APathak666/Hyperloop-2017-Sorted-/PCB/PCBs_routed/FINAL_PCBS/control_pcb_final/CONTROL PCB.pdf

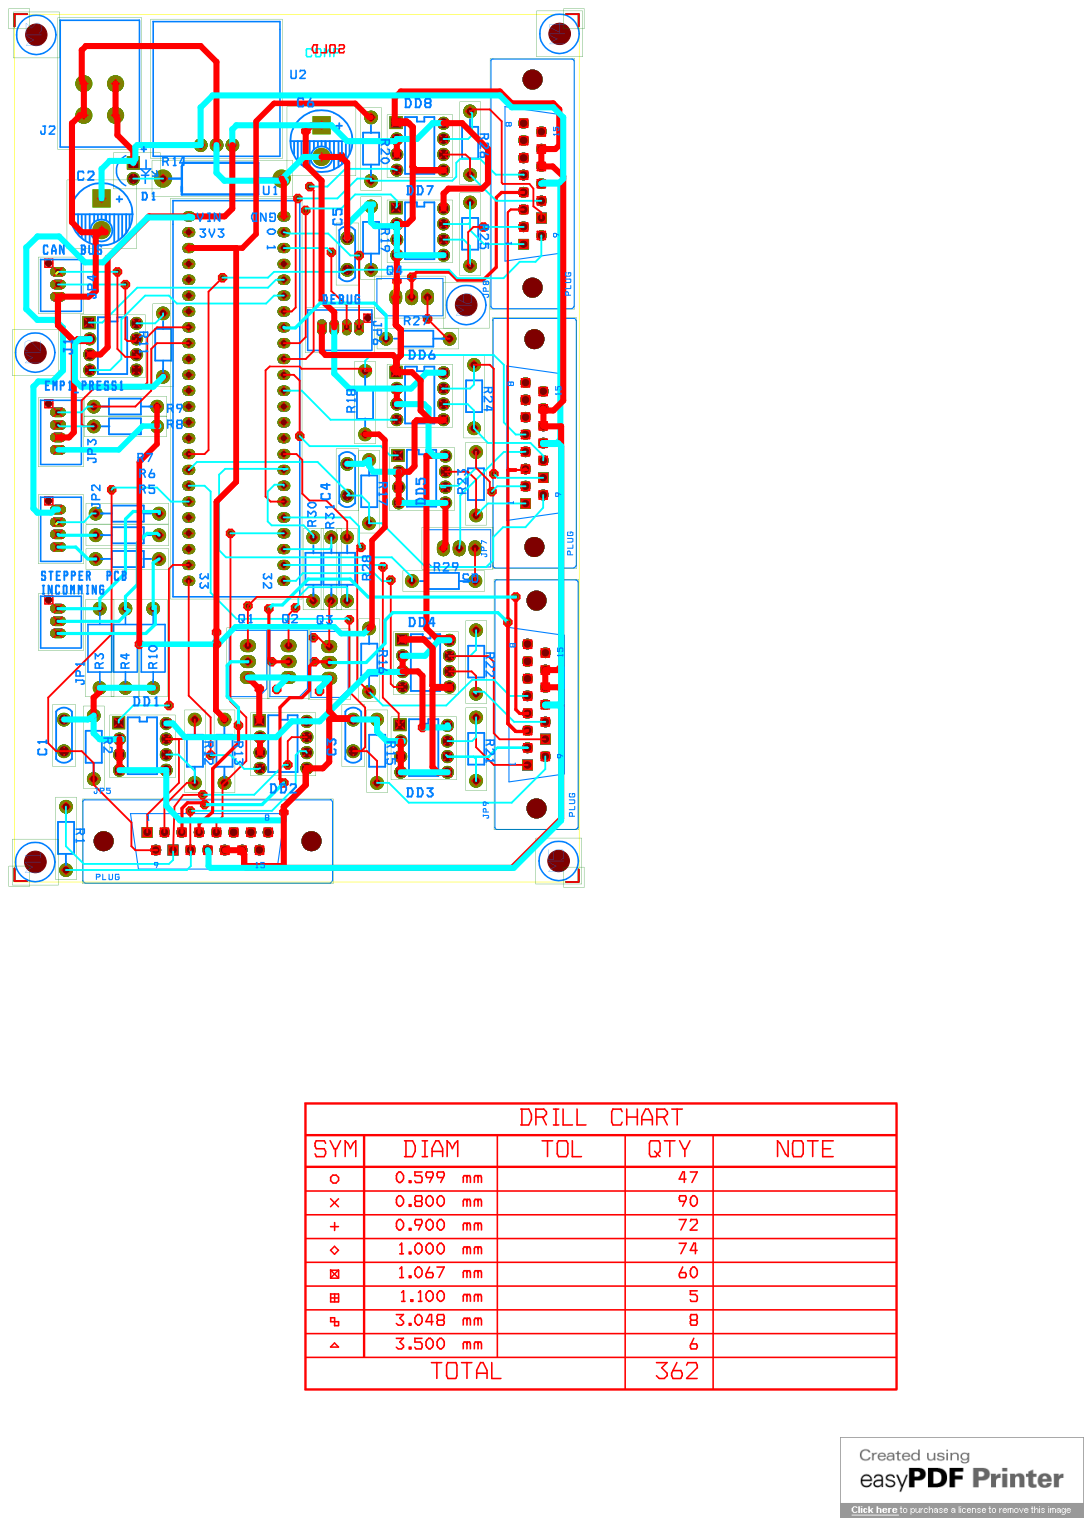
[picture p2: page 1]
