APathak666/Hyperloop-2017-Sorted-/PCB/PCBs_routed/FINAL_PCBS/navigation_pcb_final/NAV PCB.pdf

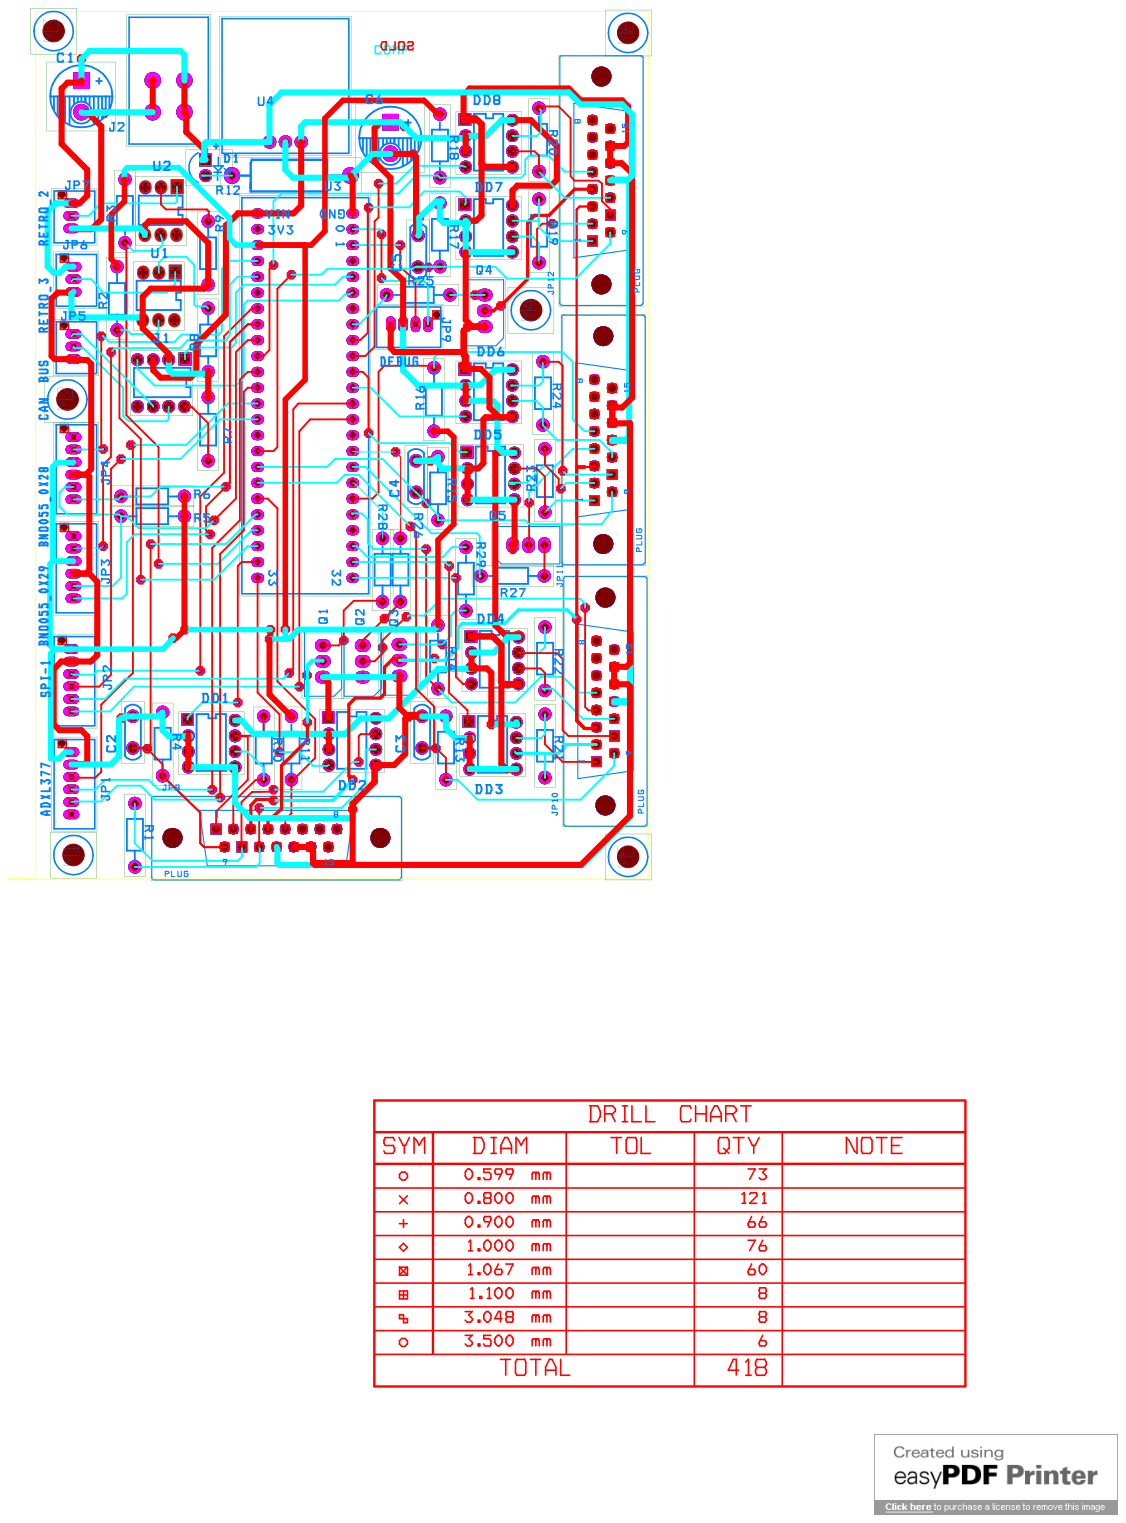
[picture p3: page 1]
