APathak666/Hyperloop-2017-Sorted-/PCB/PCBs_routed/FINAL_PCBS/power_pcb_final/power boad pcb.pdf

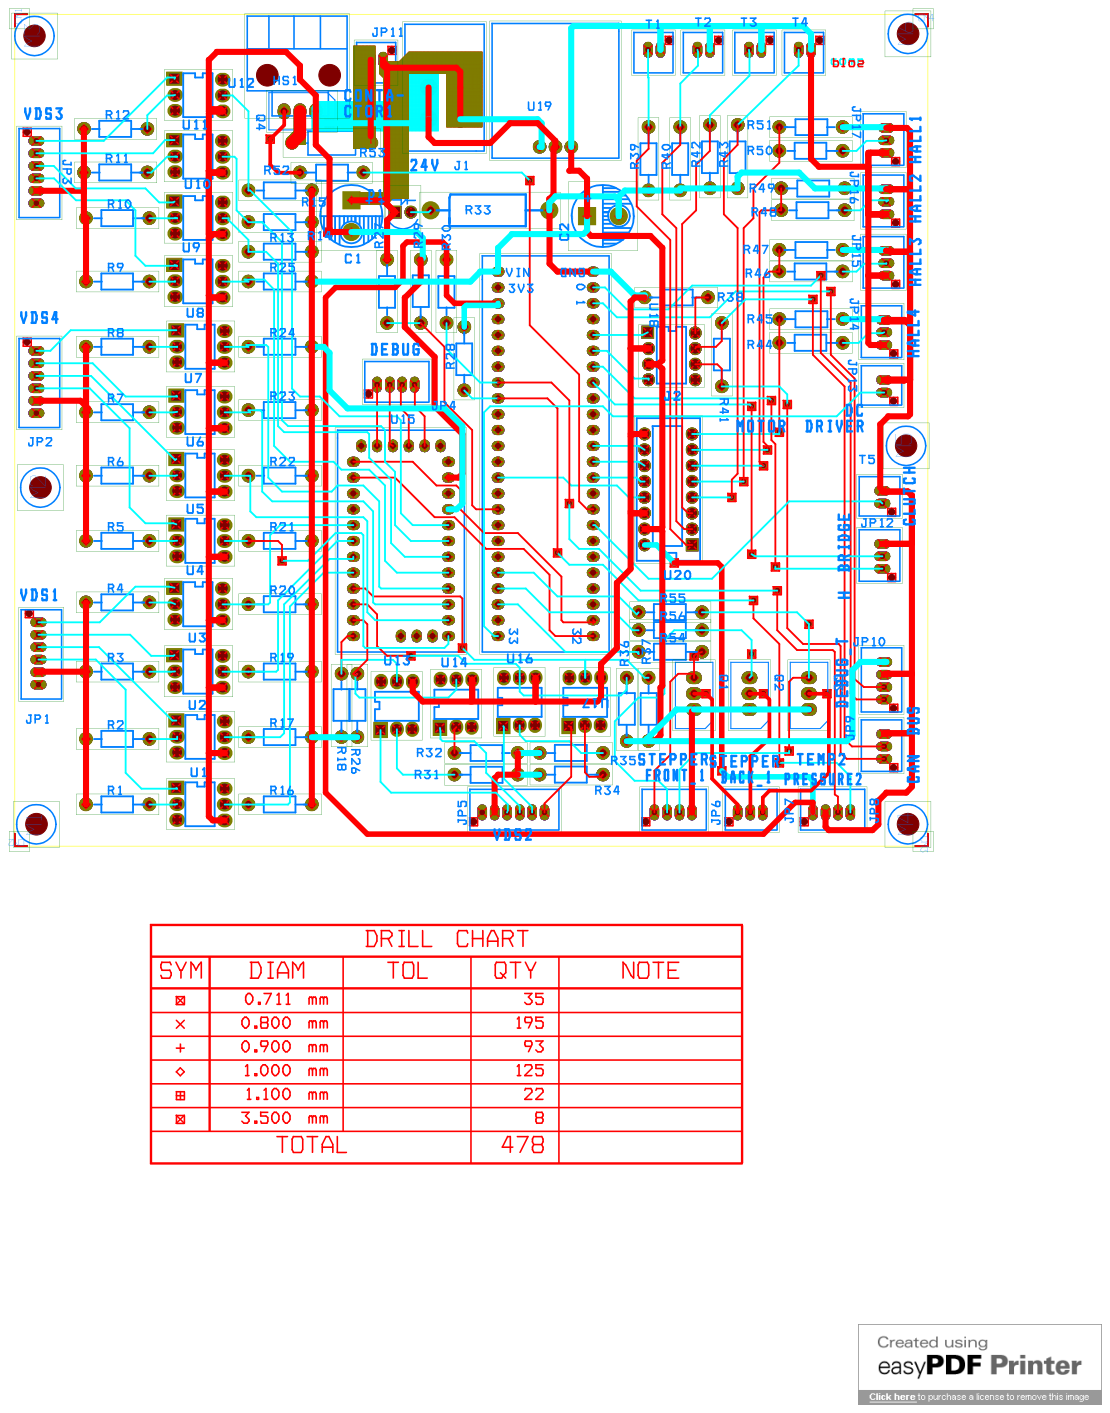
[picture p4: page 1]
