APathak666/Hyperloop-2017-Sorted-/UML jpeg/1 - Page 1.jpeg

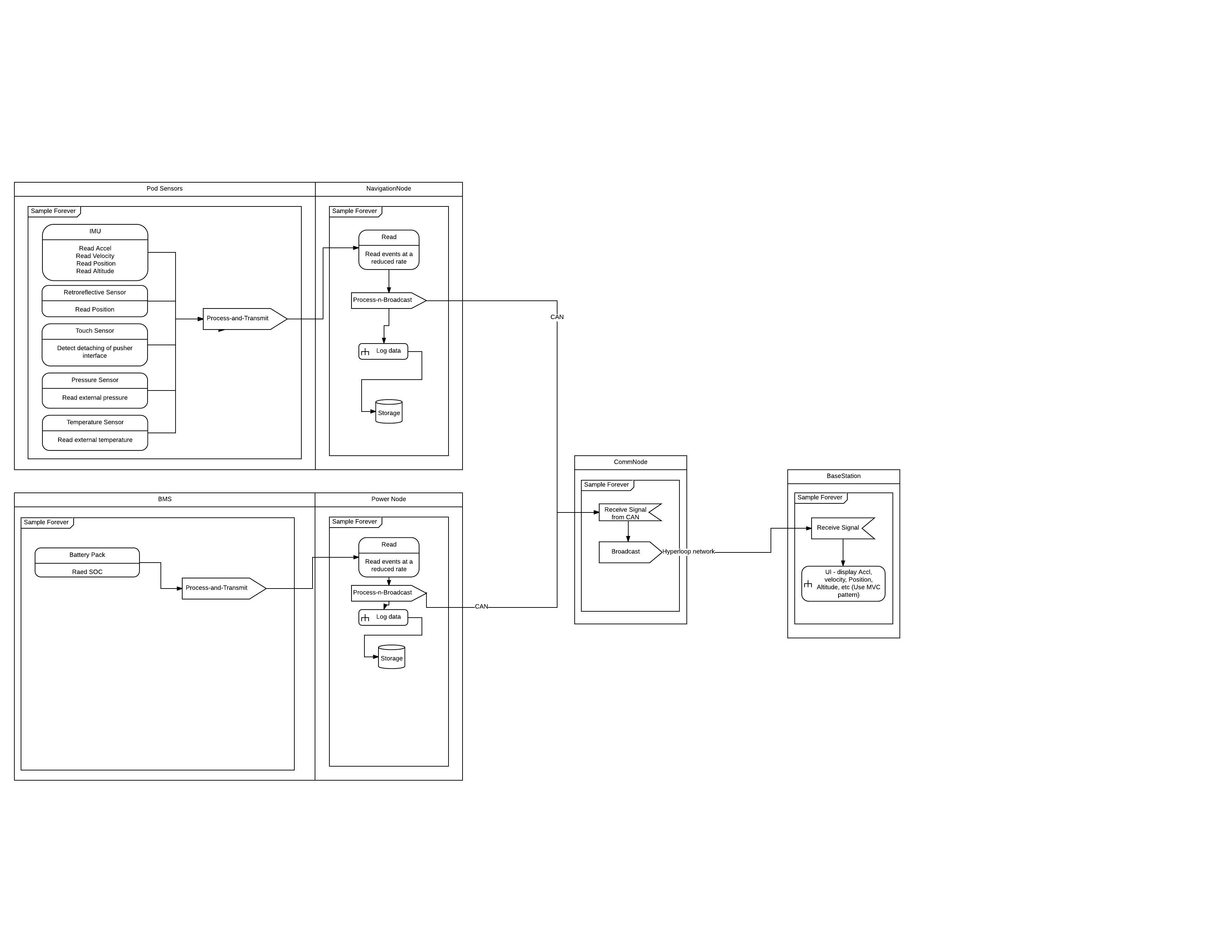
UML jpeg/1 - Page 1.jpeg
