APathak666/Hyperloop-2017-Sorted-/UML jpeg/2 - Page 1.jpeg

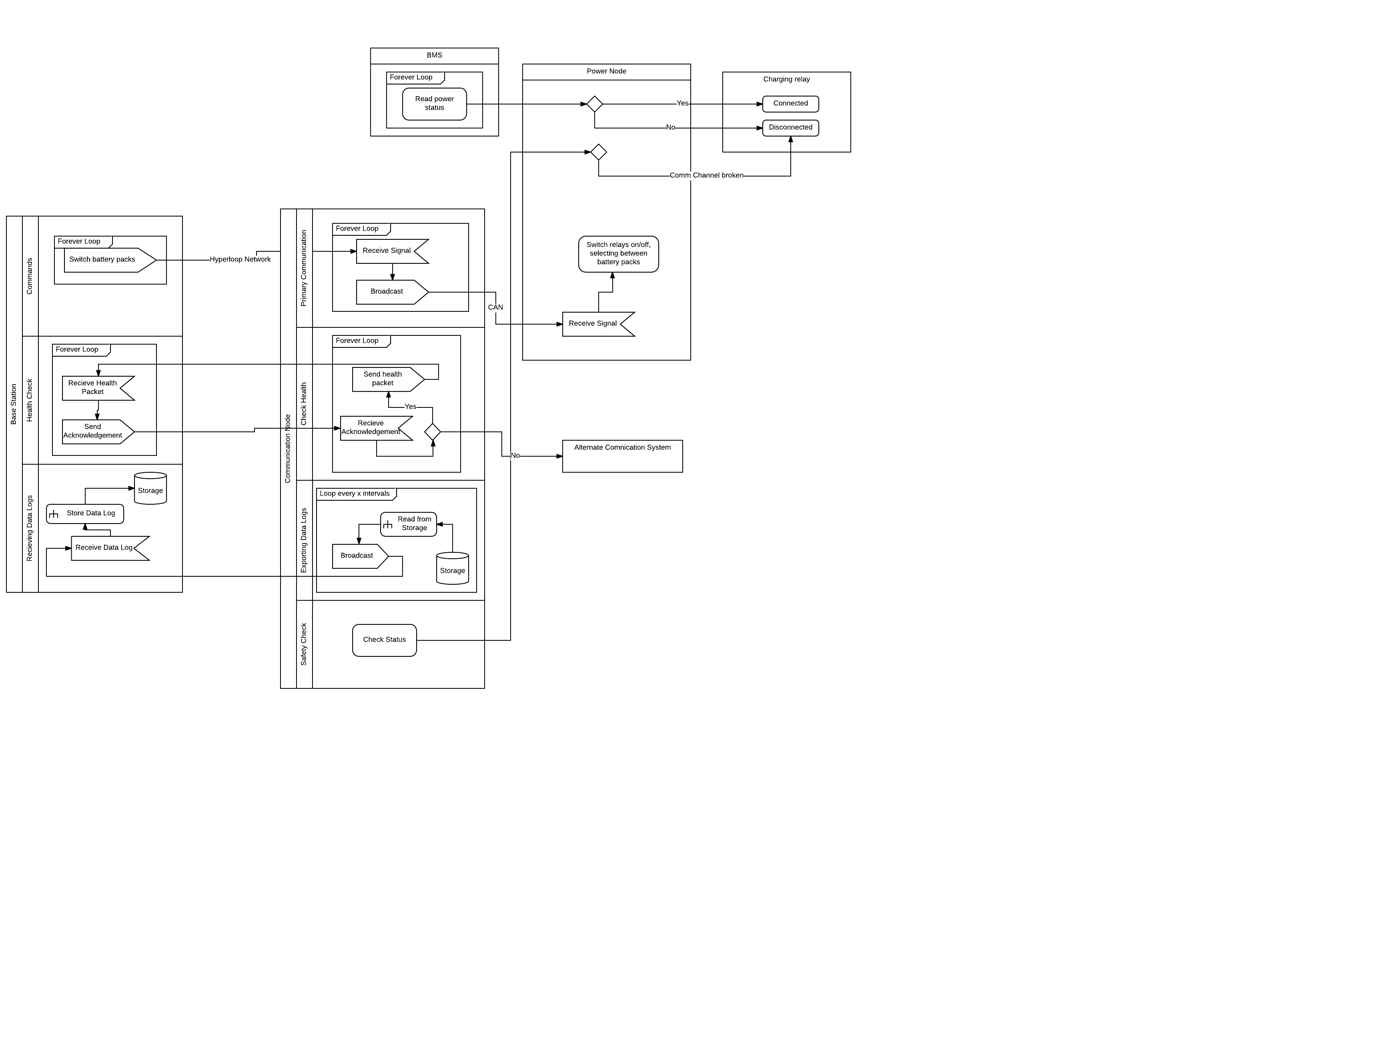
UML jpeg/2 - Page 1.jpeg
