APathak666/Hyperloop-2017-Sorted-/UML jpeg/3 - Page 1.jpeg

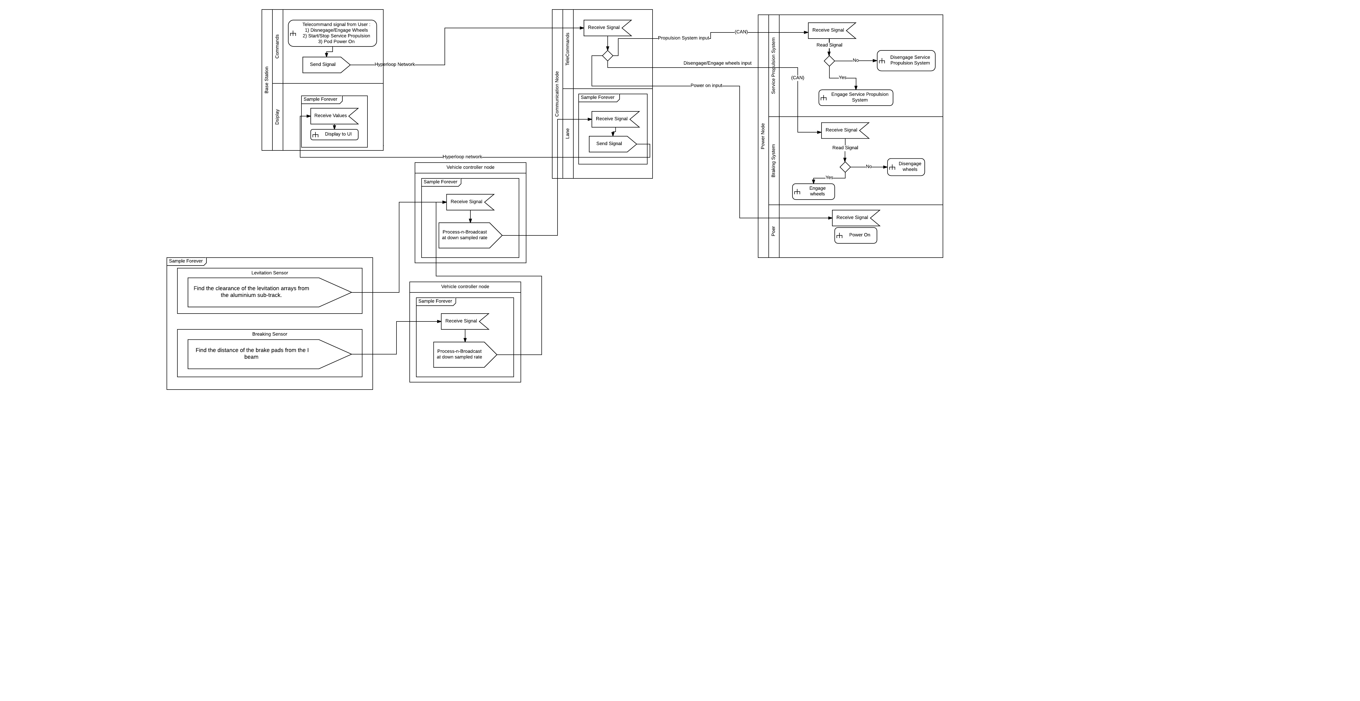
UML jpeg/3 - Page 1.jpeg
