APathak666/Hyperloop-2017-Sorted-/UML jpeg/4 - Page 1.jpeg

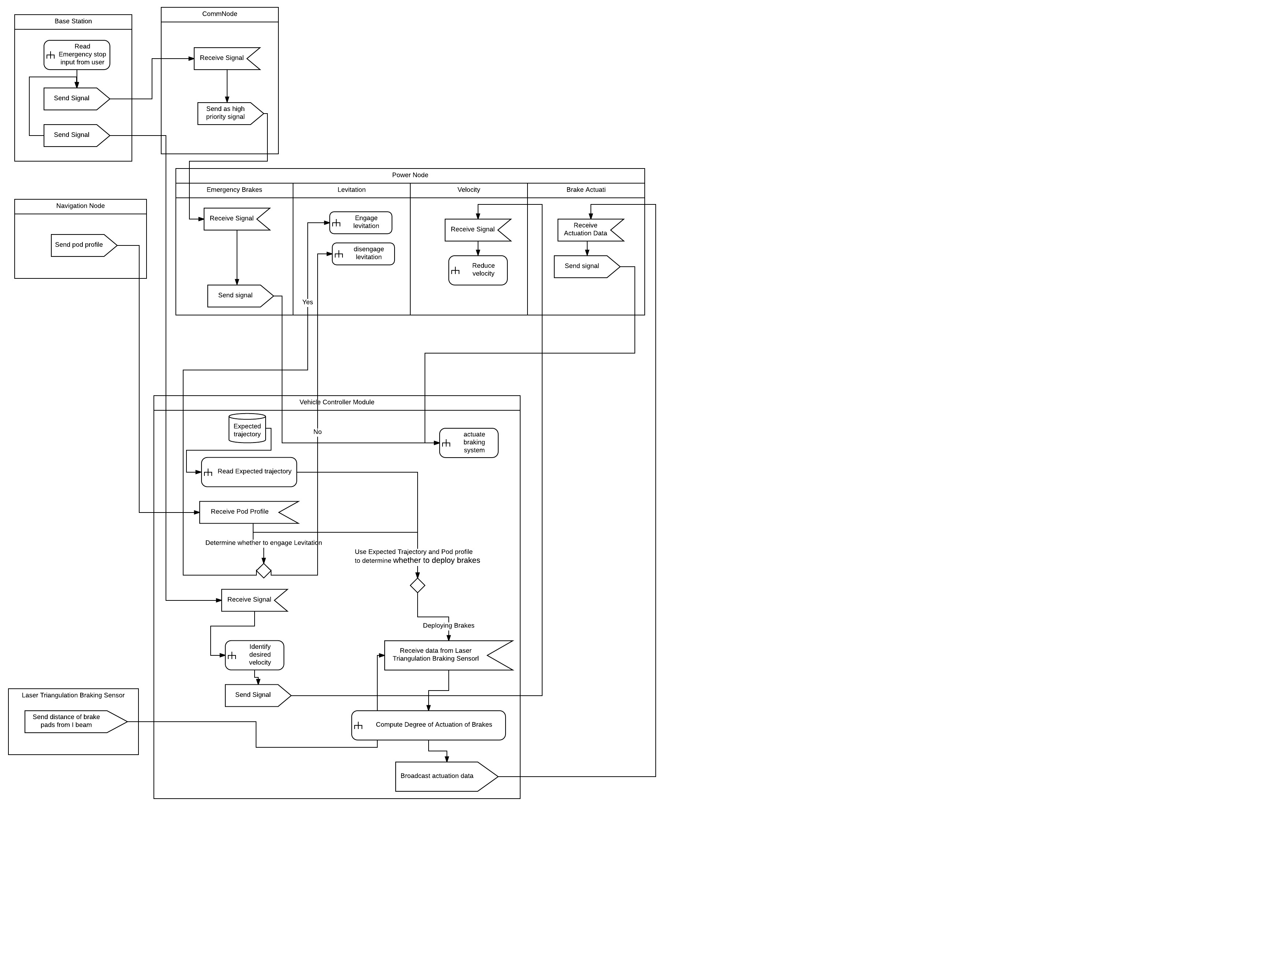
UML jpeg/4 - Page 1.jpeg
