APathak666/Hyperloop-2017-Sorted-/UML jpeg/cd_Communication.png

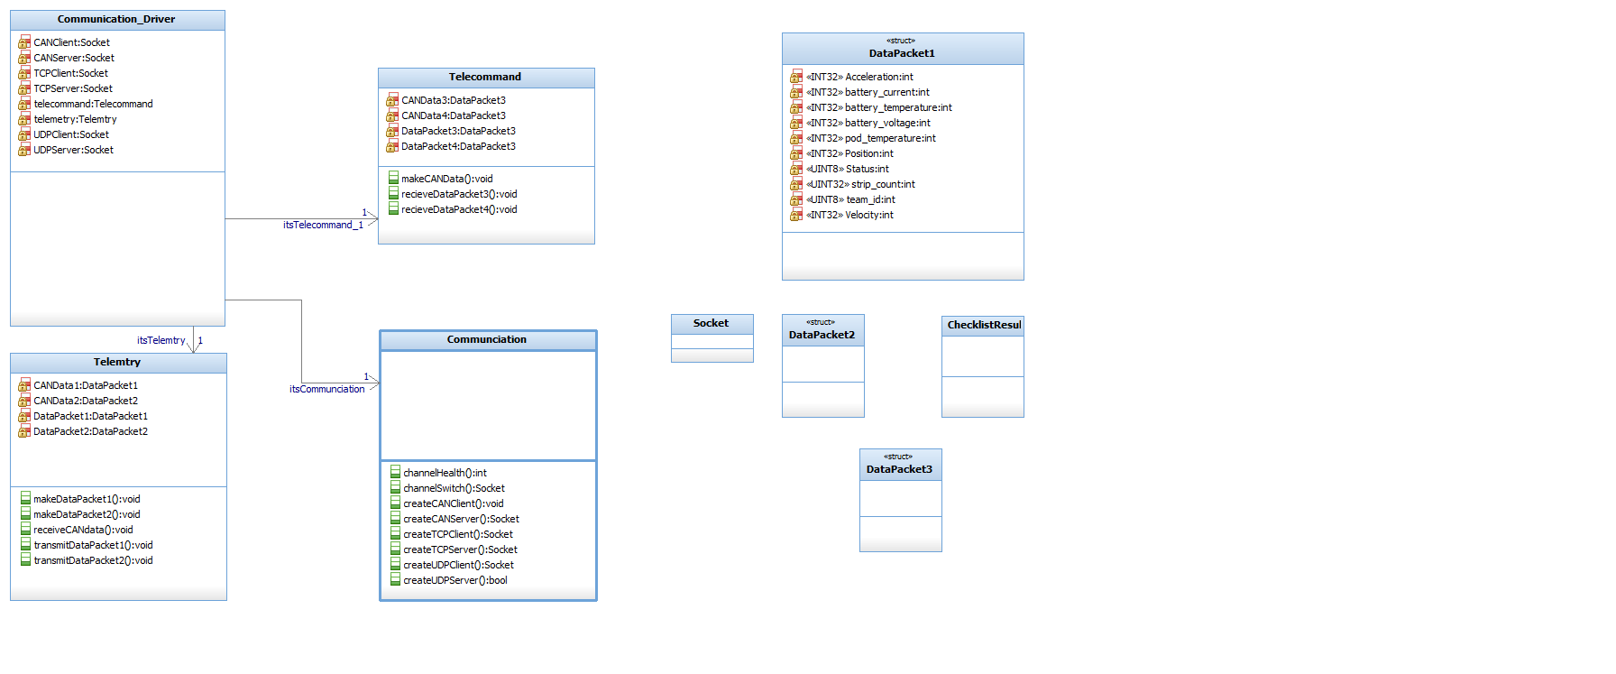
UML jpeg/cd_Communication.png
