APathak666/Hyperloop-2017-Sorted-/UML jpeg/cd_vehicleCont.png

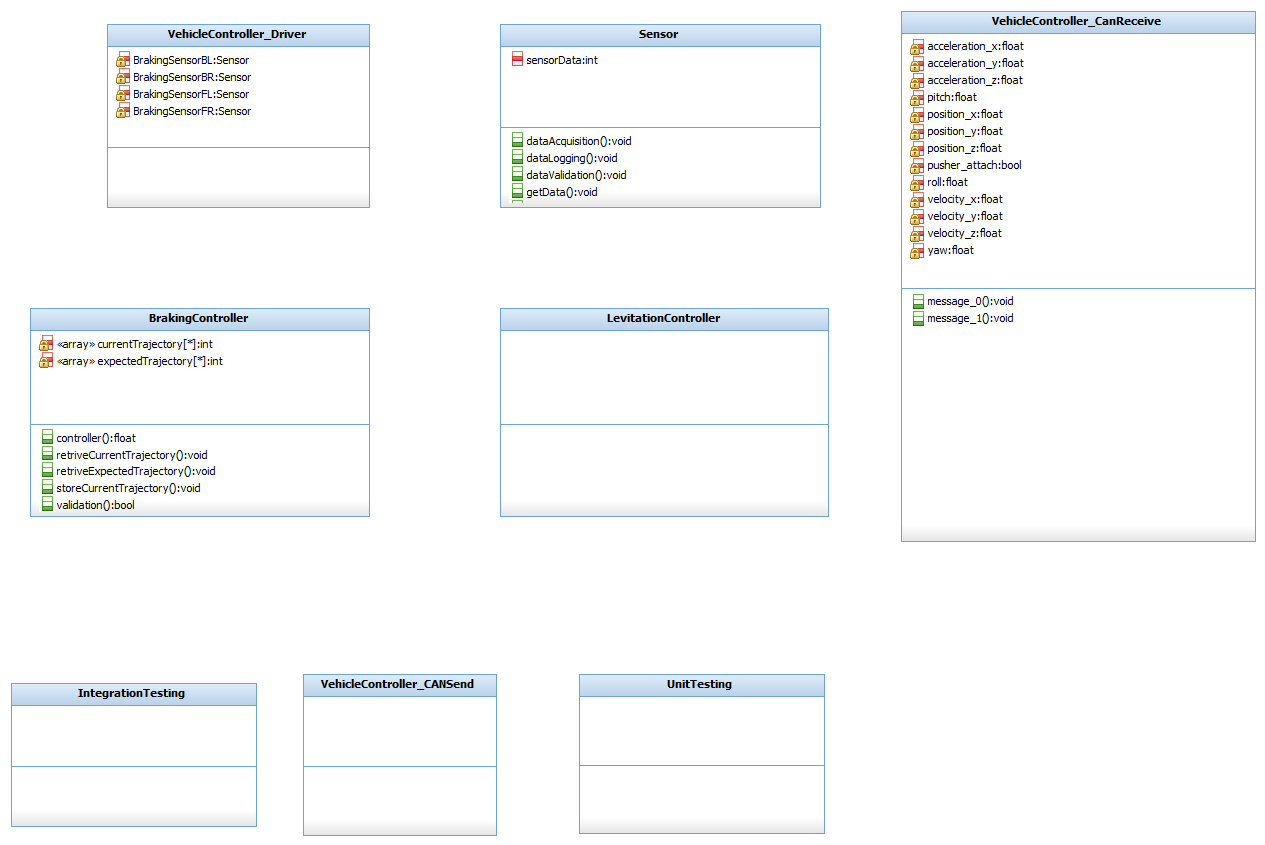
UML jpeg/cd_vehicleCont.png
