APathak666/Hyperloop-2017-Sorted-/UML jpeg/sd_VehCont.png

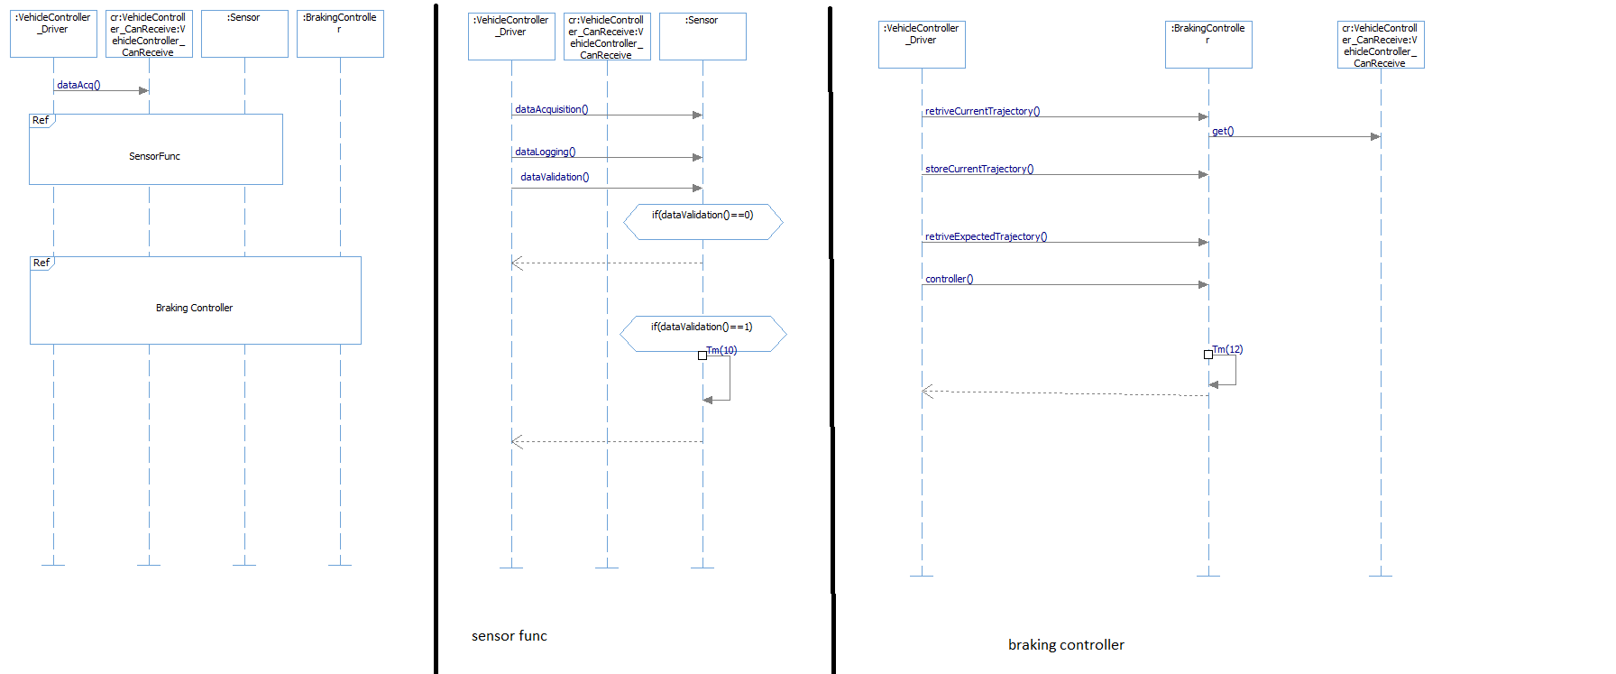
UML jpeg/sd_VehCont.png
