APathak666/Hyperloop-2017-Sorted-/PCB/BOM for PCBs/PCB specifics - Control.pdf

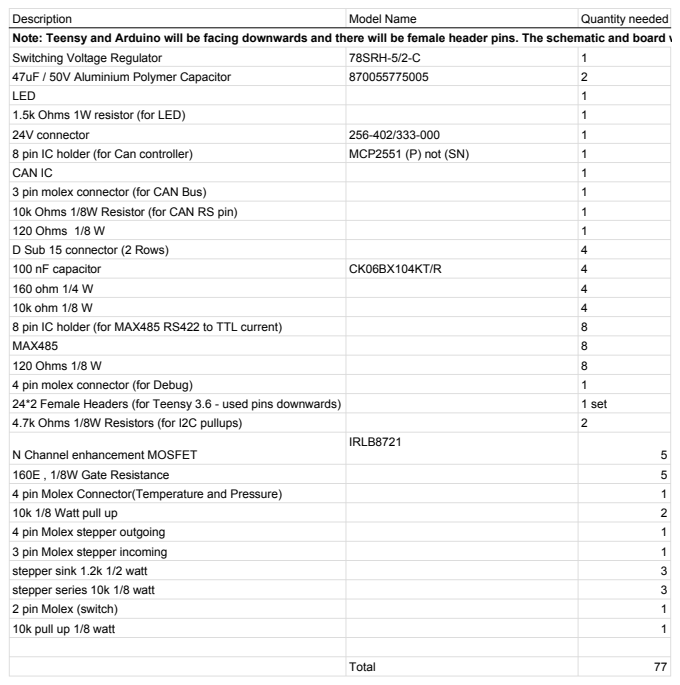
[picture p12: page 1]
Description; Model Name; Quantity needed; Switching Voltage Regulator; 78SRH-5/2-C; 47uF / 50V Aluminium Polymer Capacitor; LED; 1.5k Ohms 1W resistor (for LED); 24V connector; 8 pin IC holder (for Can controller); MCP2551 (P) not (SN); CAN IC; 3 pin molex connector (for CAN Bus); 10k Ohms 1/8W Resistor (for CAN RS pin); 120 Ohms 1/8 W; D Sub 15 connector (2 Rows); 100 nF capacitor; 160 ohm 1/4 W; 10k ohm 1/8 W; 8 pin IC holder (for MAX485 RS422 to TTL current); MAX485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

N Channel enhancement MOSFET

Datasheet Link

http://www.mouser.com/ds/2/281/mpm_78sr-2a_a00-42390.pdf

http://katalog.we-online.de/pbs/datasheet/870055775005.pdf

Not Required

Not Required
https://drive.google.com/open?id=0B4PBstU5QzLGaUNWOWhXWmkwd1k

http://ww1.microchip.com/downloads/en/DeviceDoc/21667f.pdf

https://drive.google.com/open?id=0B4PBstU5QzLGaGszWDctNzRNTTg

Not Required

Not Required
https://drive.google.com/a/bits-pilani.ac.in/file/d/0B4PBstU5QzLGNXZ1eFRmdVlKalk/view?usp=drivesdk

http://www.kemet.com/Lists/ProductCatalog/Attachments/10/F3101_MIL-PRF-11015.pdf

Not Required

Not Required
https://datasheets.maximintegrated.com/en/ds/MAX1487-MAX491.pdf

https://datasheets.maximintegrated.com/en/ds/MAX1487-MAX491.pdf

Not Required
https://drive.google.com/open?id=0B4PBstU5QzLGaGszWDctNzRNTTg

https://www.pjrc.com/store/teensy36.html

Not Required

Not Required

https://drive.google.com/open?id=0B4PBstU5QzLGaGszWDctNzRNTTg

Not Required
https://drive.google.com/open?id=0B4PBstU5QzLGaGszWDctNzRNTTg

https://drive.google.com/open?id=0B4PBstU5QzLGaGszWDctNzRNTTg

Not Required

Not Required
https://drive.google.com/open?id=0B4PBstU5QzLGaGszWDctNzRNTTg

Not Required
