APathak666/Hyperloop-2017-Sorted-/PCB/BOM for PCBs/PCB specifics - Navigation Node.pdf

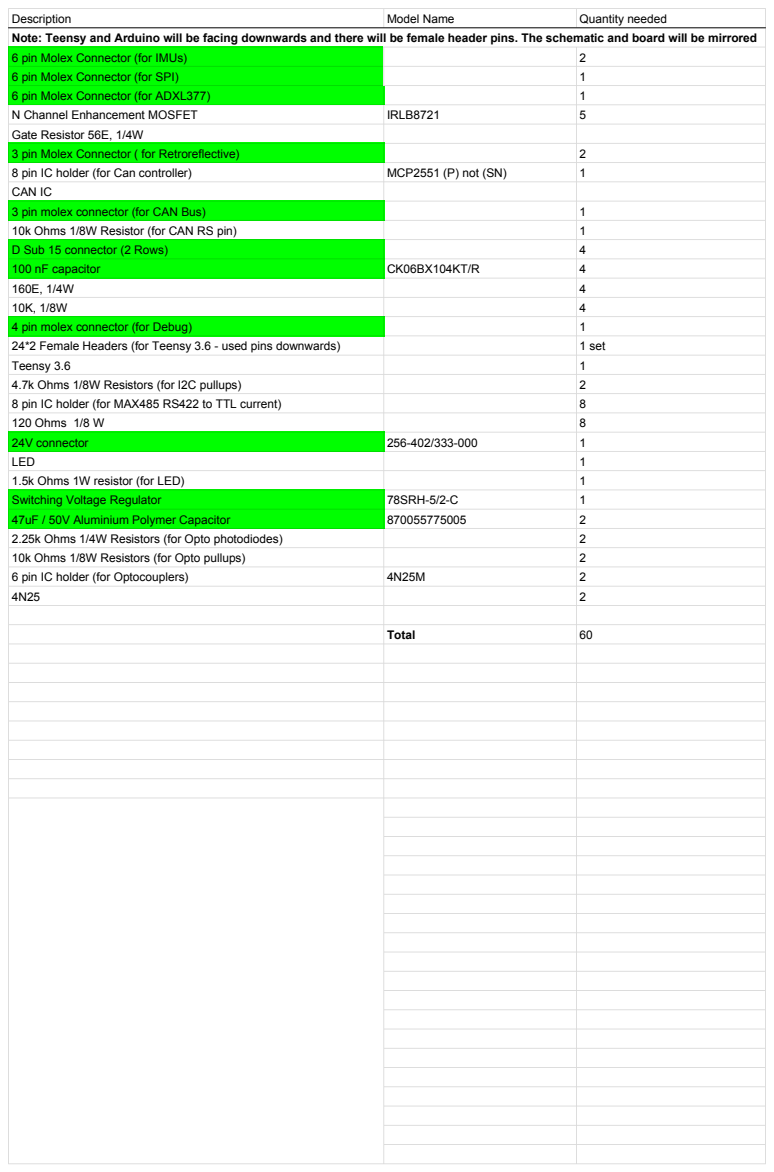
[picture p13: page 1]
Description; Model Name; Quantity needed; 6 pin Molex Connector (for IMUs); 6 pin Molex Connector (for SPI); 6 pin Molex Connector (for ADXL377); N Channel Enhancement MOSFET; IRLB8721; 3 pin Molex Connector ( for Retroreflective); 8 pin IC holder (for Can controller); MCP2551 (P) not (SN); 3 pin molex connector (for CAN Bus); 10k Ohms 1/8W Resistor (for CAN RS pin); D Sub 15 connector (2 Rows); 100 nF capacitor; 24*2 Female Headers (for Teensy 3.6 - used pins downwards); 1 set; Teensy 3.6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

Note: Teensy and Arduino will be facing downwards and there will be female header pins. The schematic and board will be mirrored
Gate Resistor 56E, 1/4W
CAN IC

10K, 1/8W | 4
4 pin molex connector (for Debug) | 1

Datasheet Link

https://drive.google.com/open?id=0B4PBstU5QzLGaGszWDctNzRNTTg

https://drive.google.com/open?id=0B4PBstU5QzLGaGszWDctNzRNTTg

https://drive.google.com/open?id=0B4PBstU5QzLGaGszWDctNzRNTTg

Not Required

https://drive.google.com/open?id=0B4PBstU5QzLGaGszWDctNzRNTTg

http://ww1.microchip.com/downloads/en/DeviceDoc/21667f.pdf

https://drive.google.com/open?id=0B4PBstU5QzLGaGszWDctNzRNTTg

Not Required
http://service.powerdynamics.com/ec/Catalog17/Section%2007.pdf

http://www.kemet.com/Lists/ProductCatalog/Attachments/10/F3101_MIL-PRF-11015.pdf

Not Required

Not Required
https://drive.google.com/open?id=0B4PBstU5QzLGaGszWDctNzRNTTg

https://www.pjrc.com/store/teensy36.html

Not Required
https://datasheets.maximintegrated.com/en/ds/MAX1487-MAX491.pdf

Not Required
https://drive.google.com/open?id=0B4PBstU5QzLGaUNWOWhXWmkwd1k

Not Required

Not Required
http://www.mouser.com/ds/2/281/mpm_78sr-2a_a00-42390.pdf

http://katalog.we-online.de/pbs/datasheet/870055775005.pdf

Not Required

Not Required
https://www.vishay.com/docs/83725/4n25.pdf

https://www.vishay.com/docs/83725/4n25.pdf

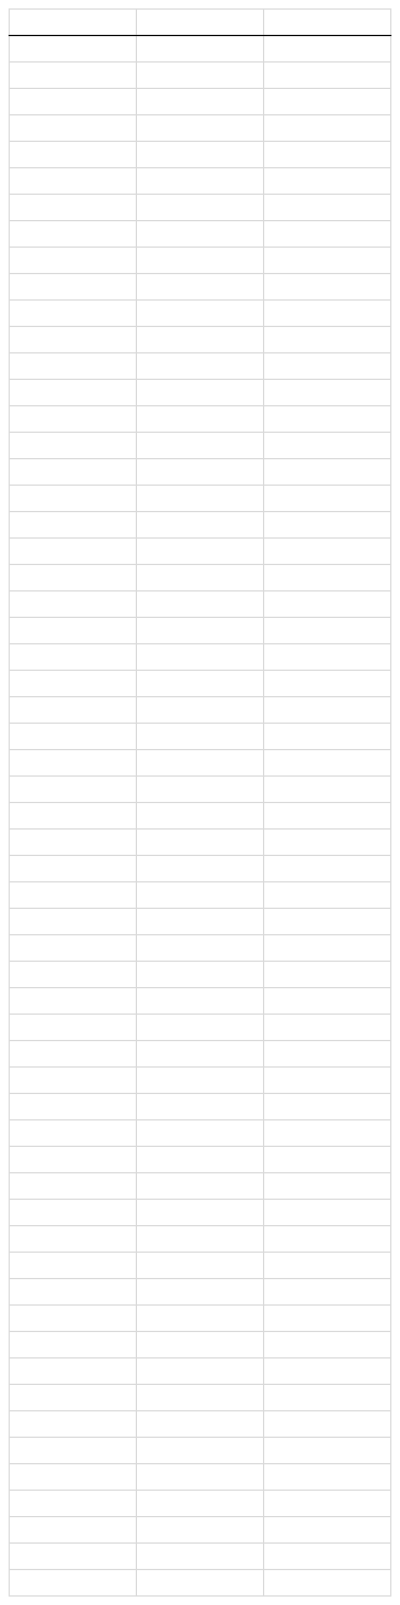
[picture p14: page 3]
