APathak666/Hyperloop-2017-Sorted-/PCB/PCBs_routed/FINAL_PCBS/CONTROL SCHEMATIC.pdf

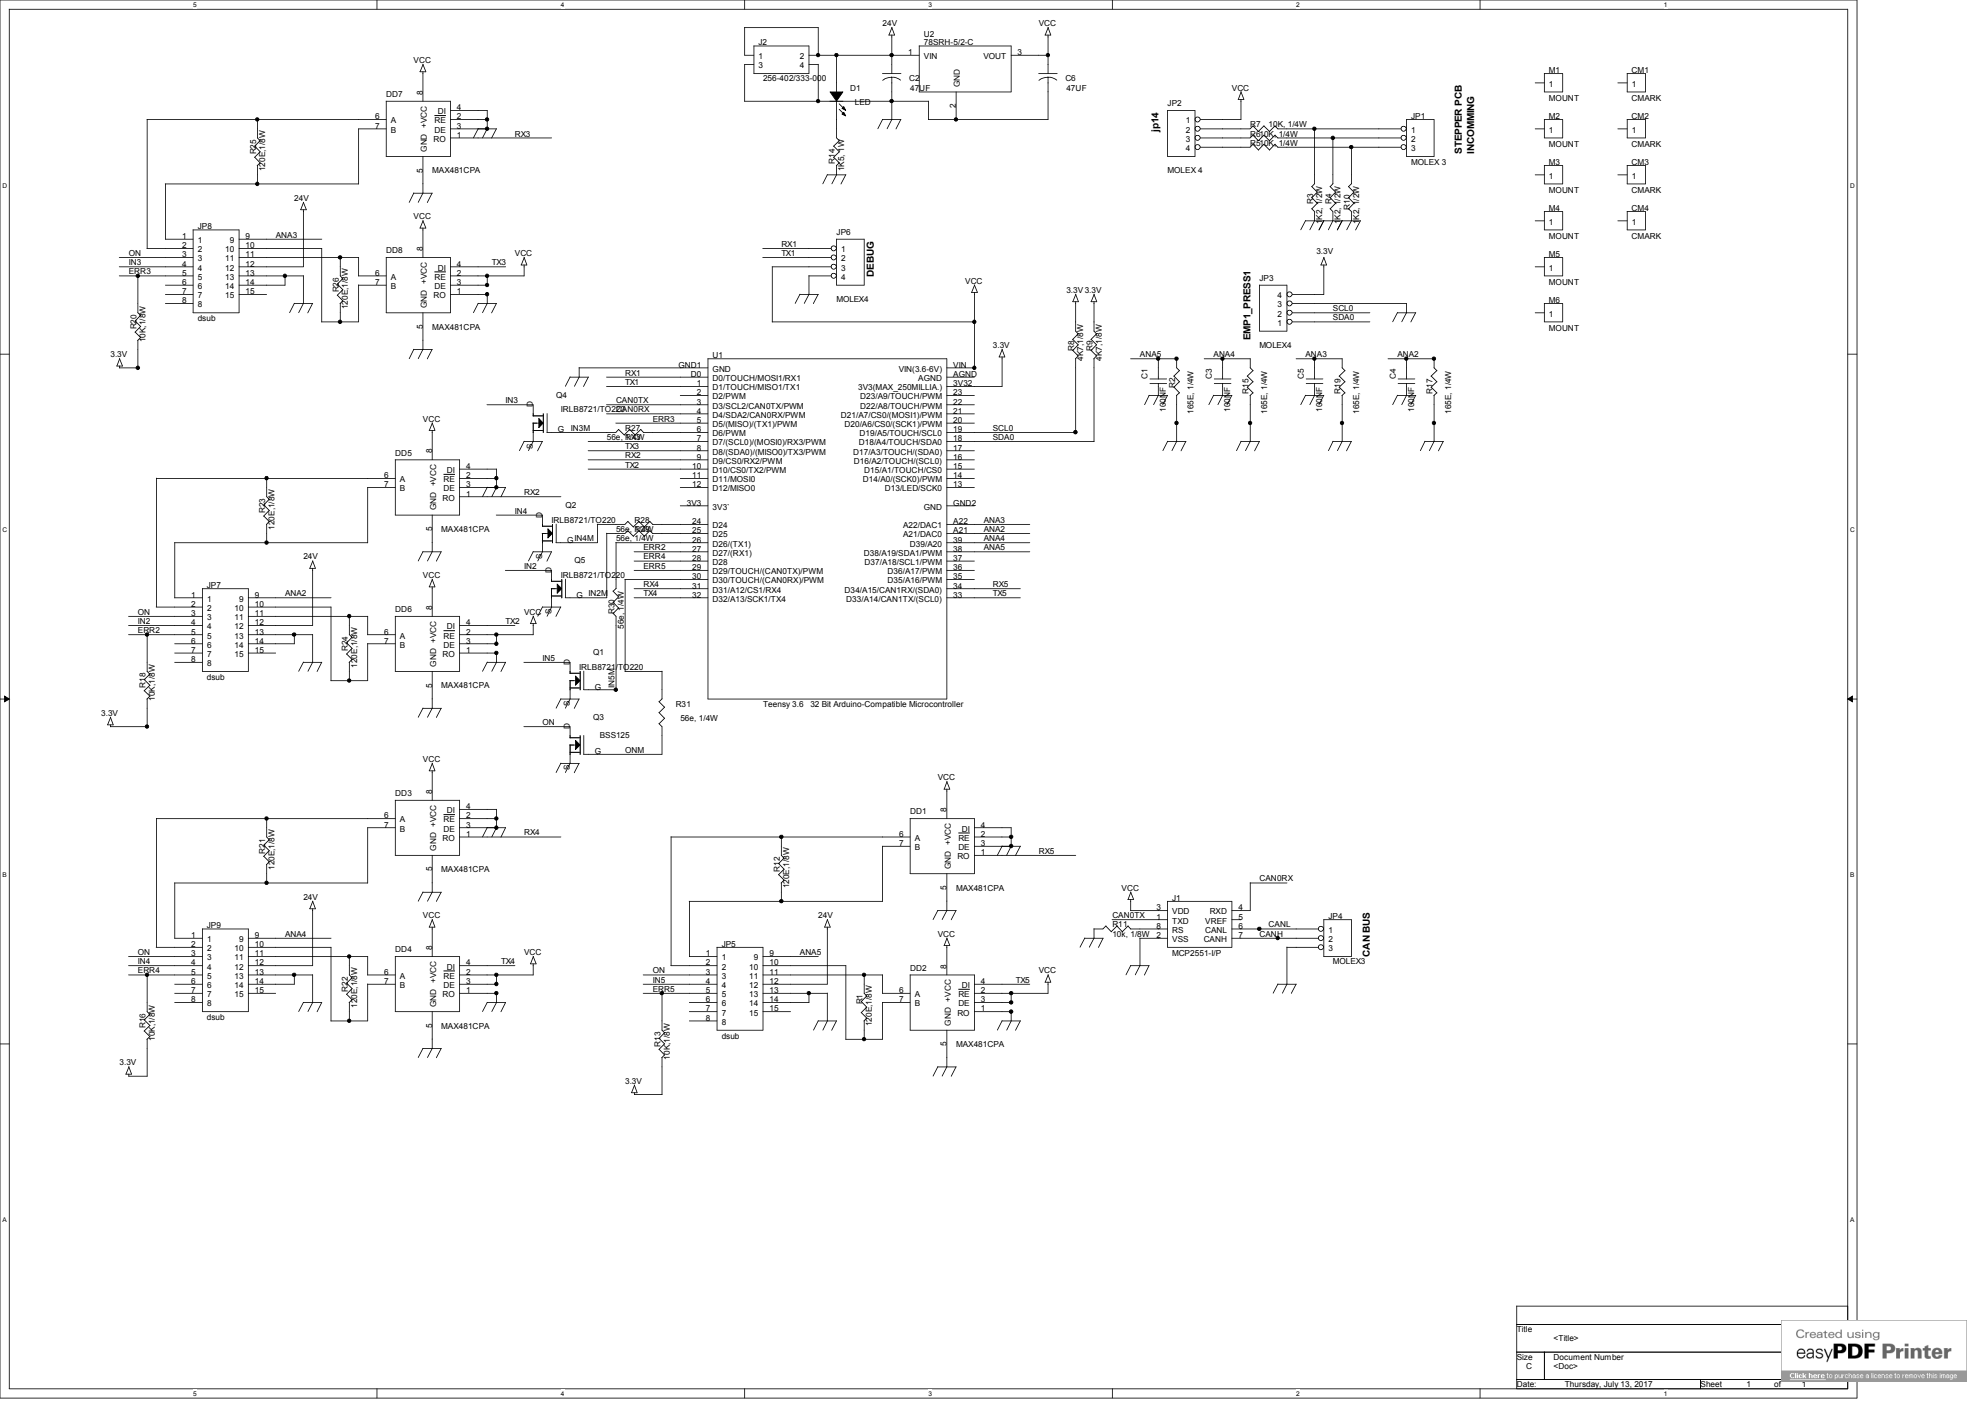
[picture p15: page 1]

Teensy 3.6 32 Bit Arduino-Compatible Microcontroller
