APathak666/Hyperloop-2017-Sorted-/PCB/PCBs_routed/FINAL_PCBS/NAV SCHEMATIC.pdf

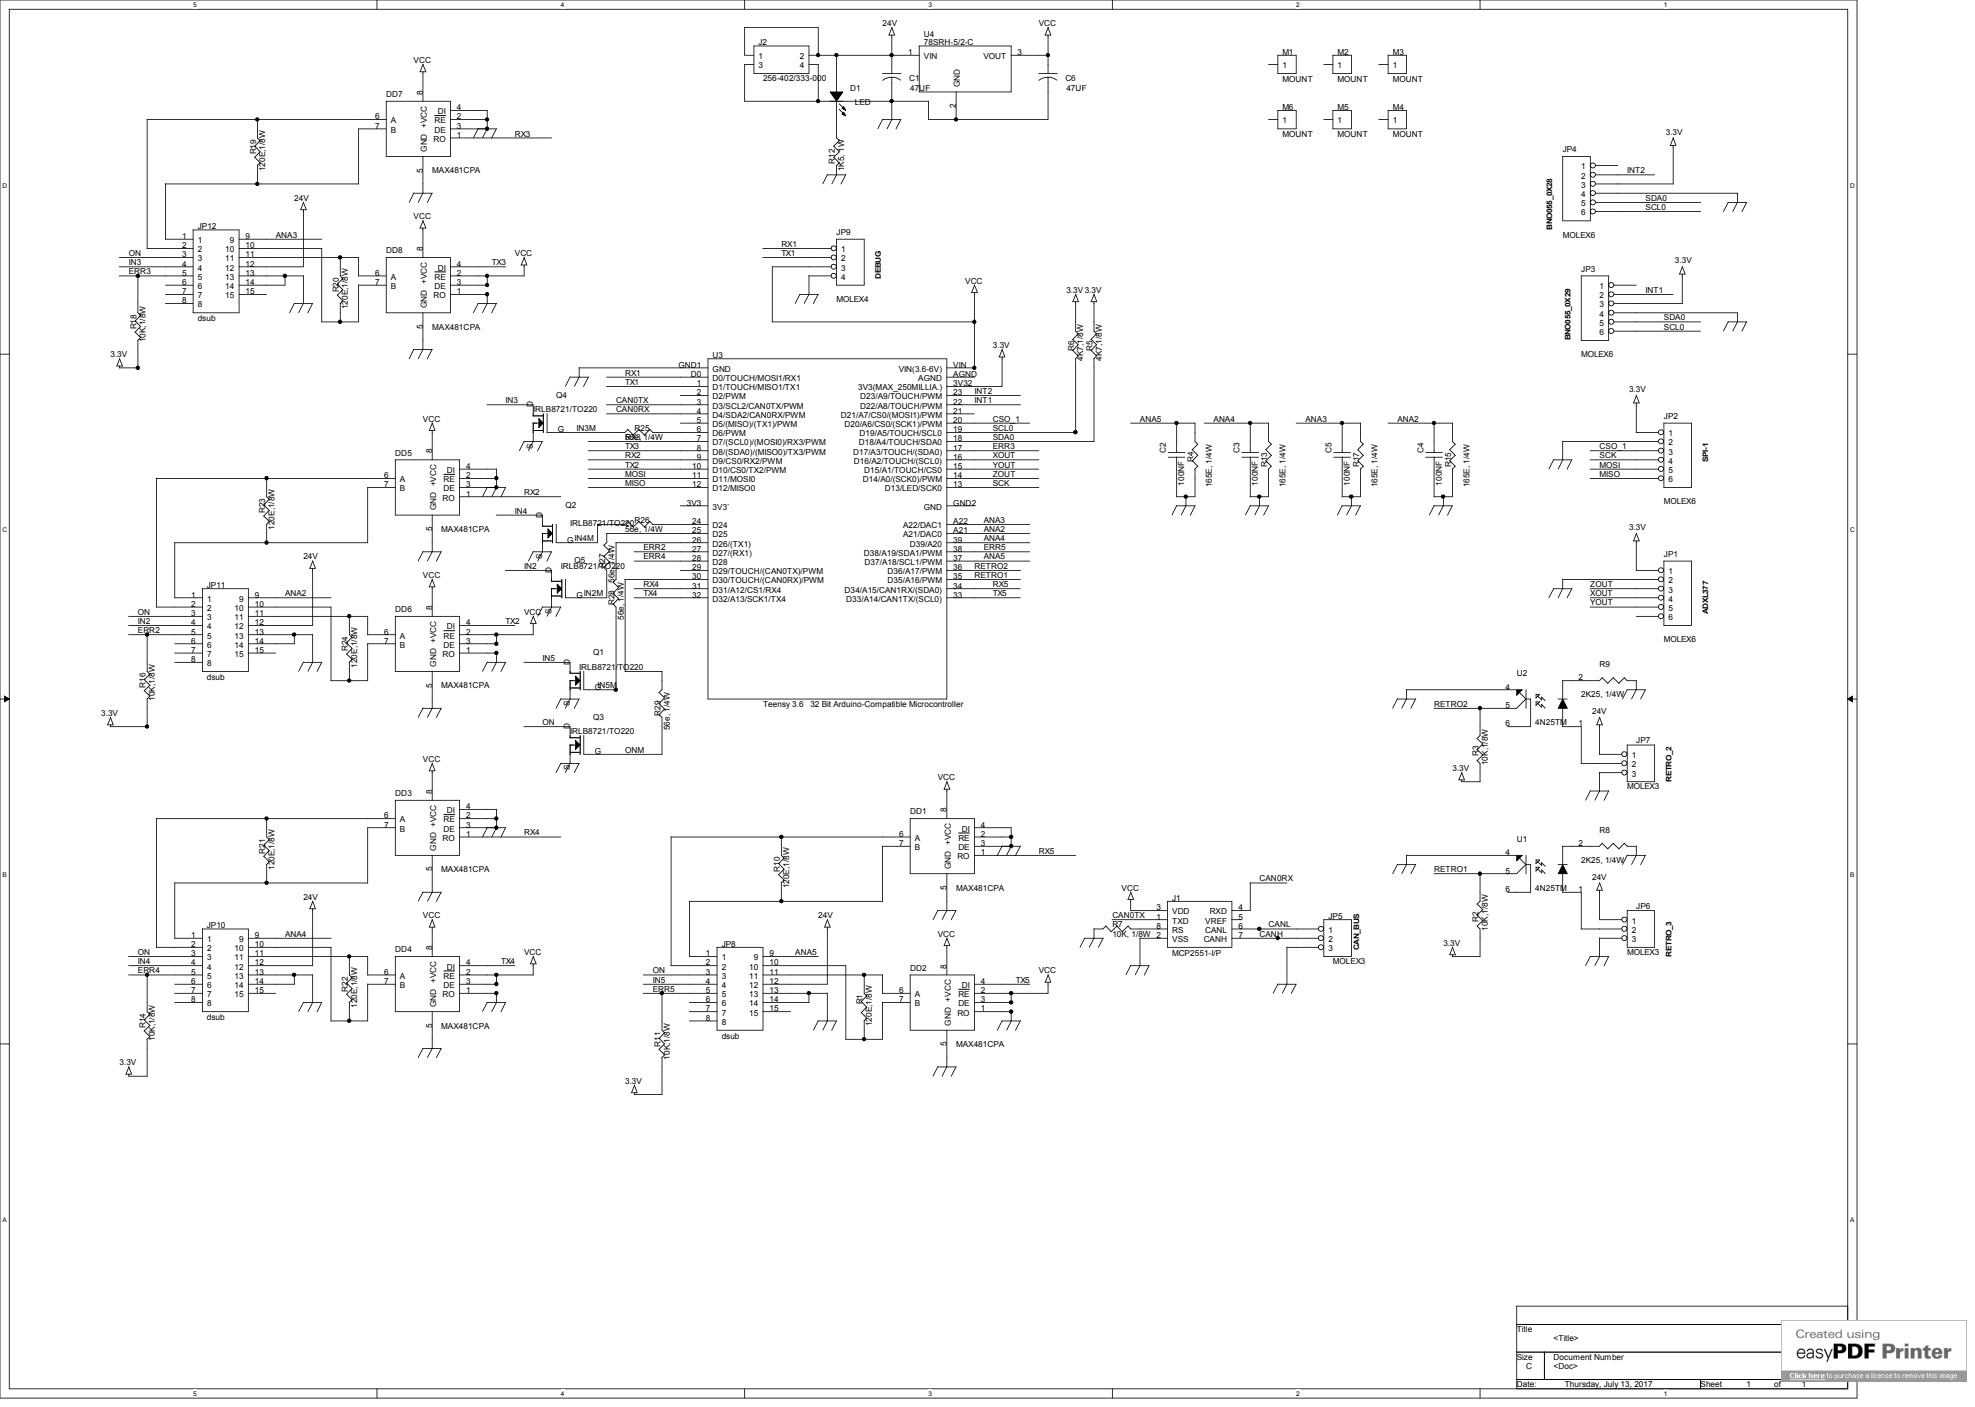
[picture p16: page 1]

Teensy 3.6 32 Bit Arduino-Compatible Microcontroller
