APathak666/Hyperloop-2017-Sorted-/PCB/PCBs_routed/FINAL_PCBS/power board schematic.pdf

### CLUTCH

### TEMP2

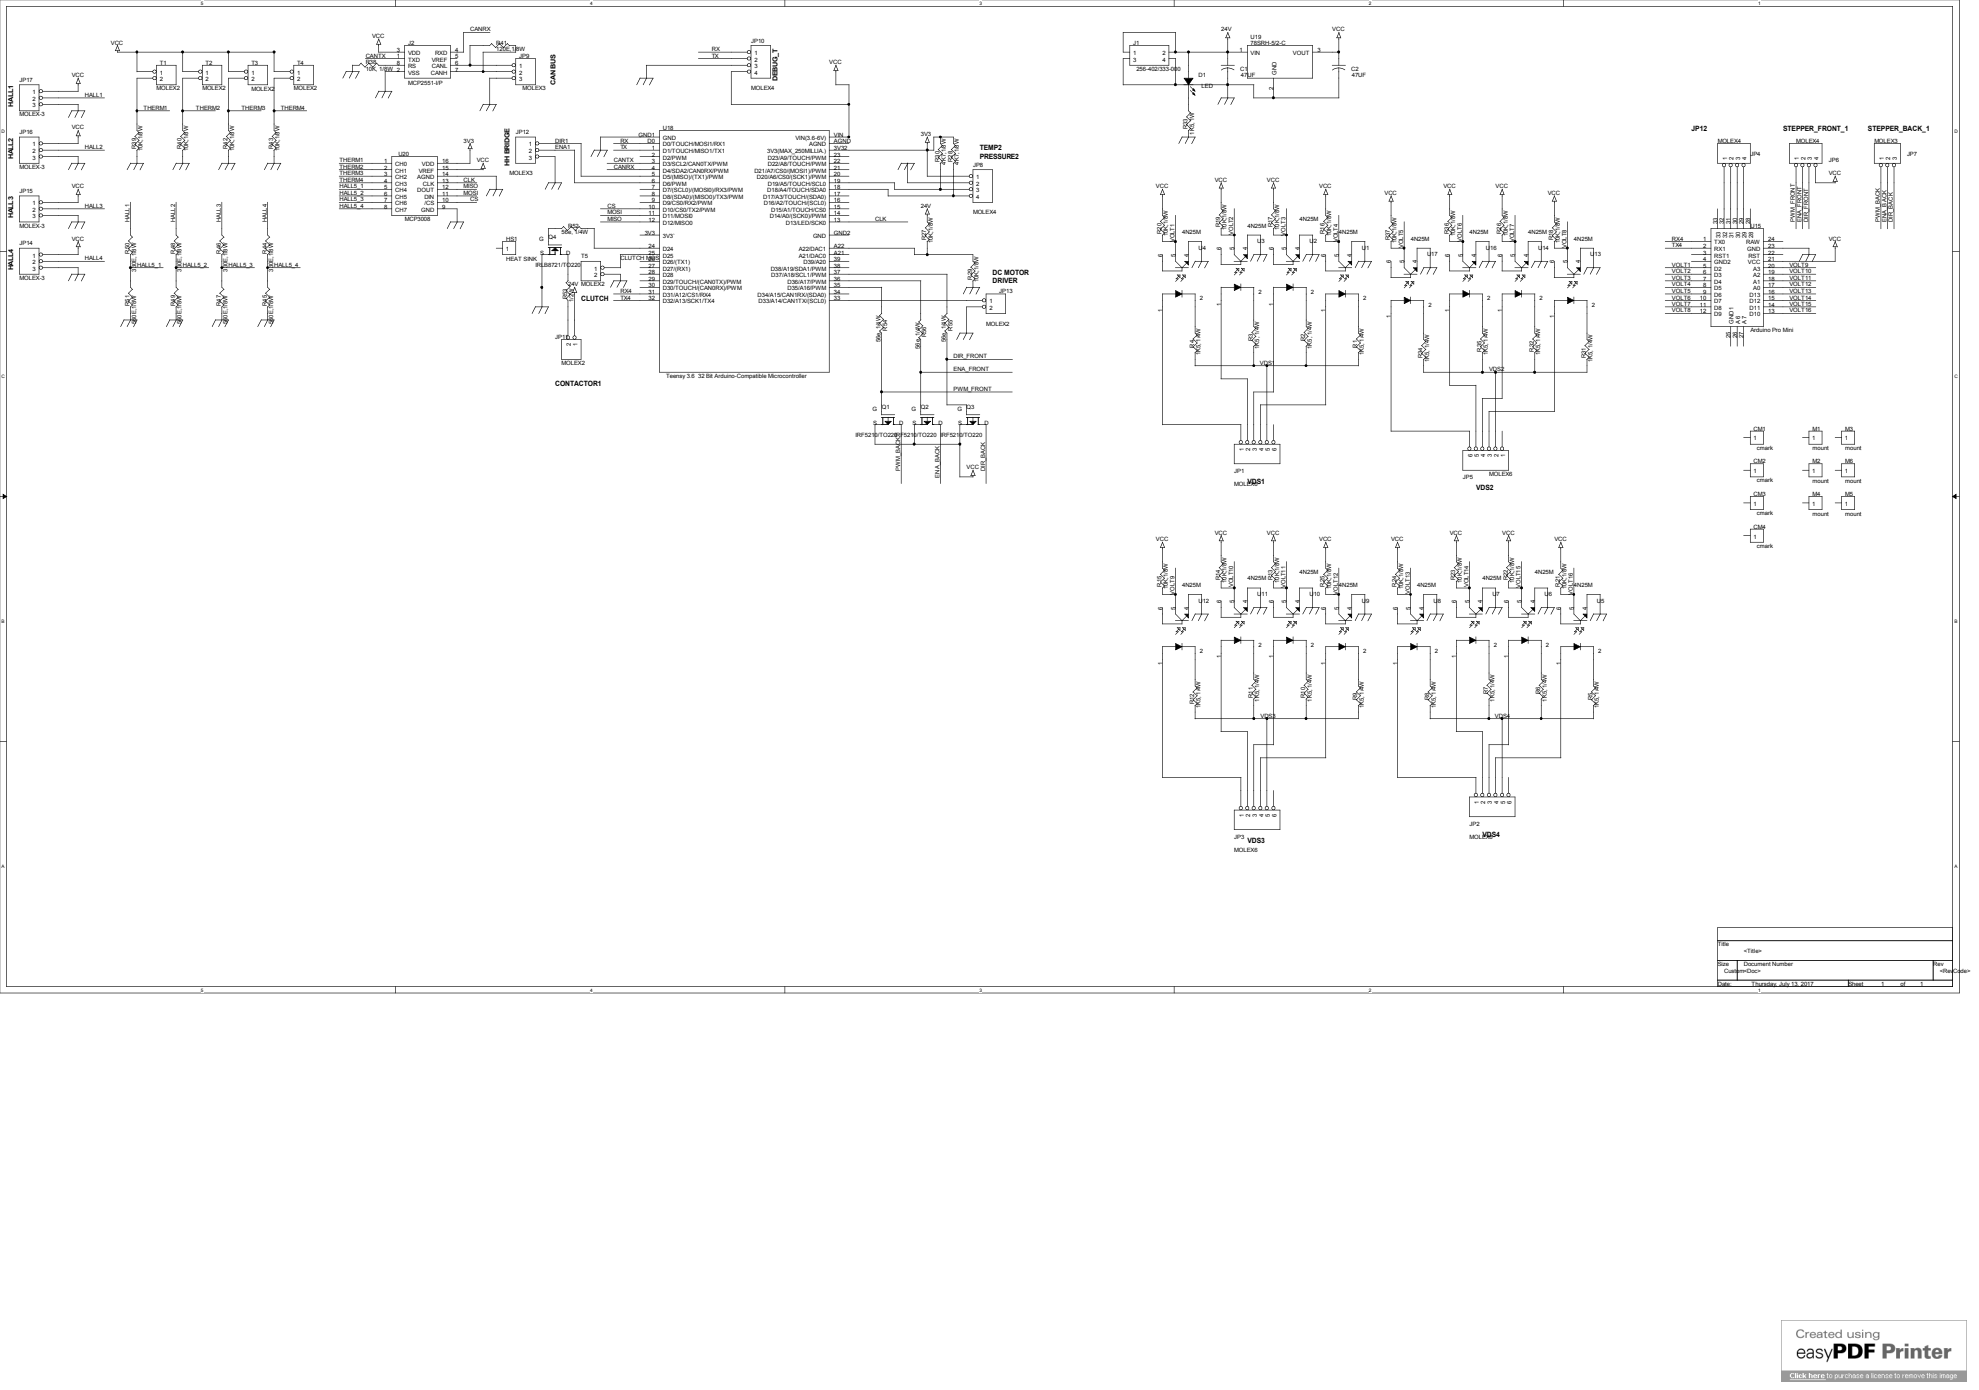
[picture p17: page 1]

Teensy 3.6 32 Bit Arduino-Compatible Microcontroller
