APathak666/Hyperloop-2017-Sorted-/pod_base_communication_final/comm schematic.pdf

# HEADER 3 123 R⁶

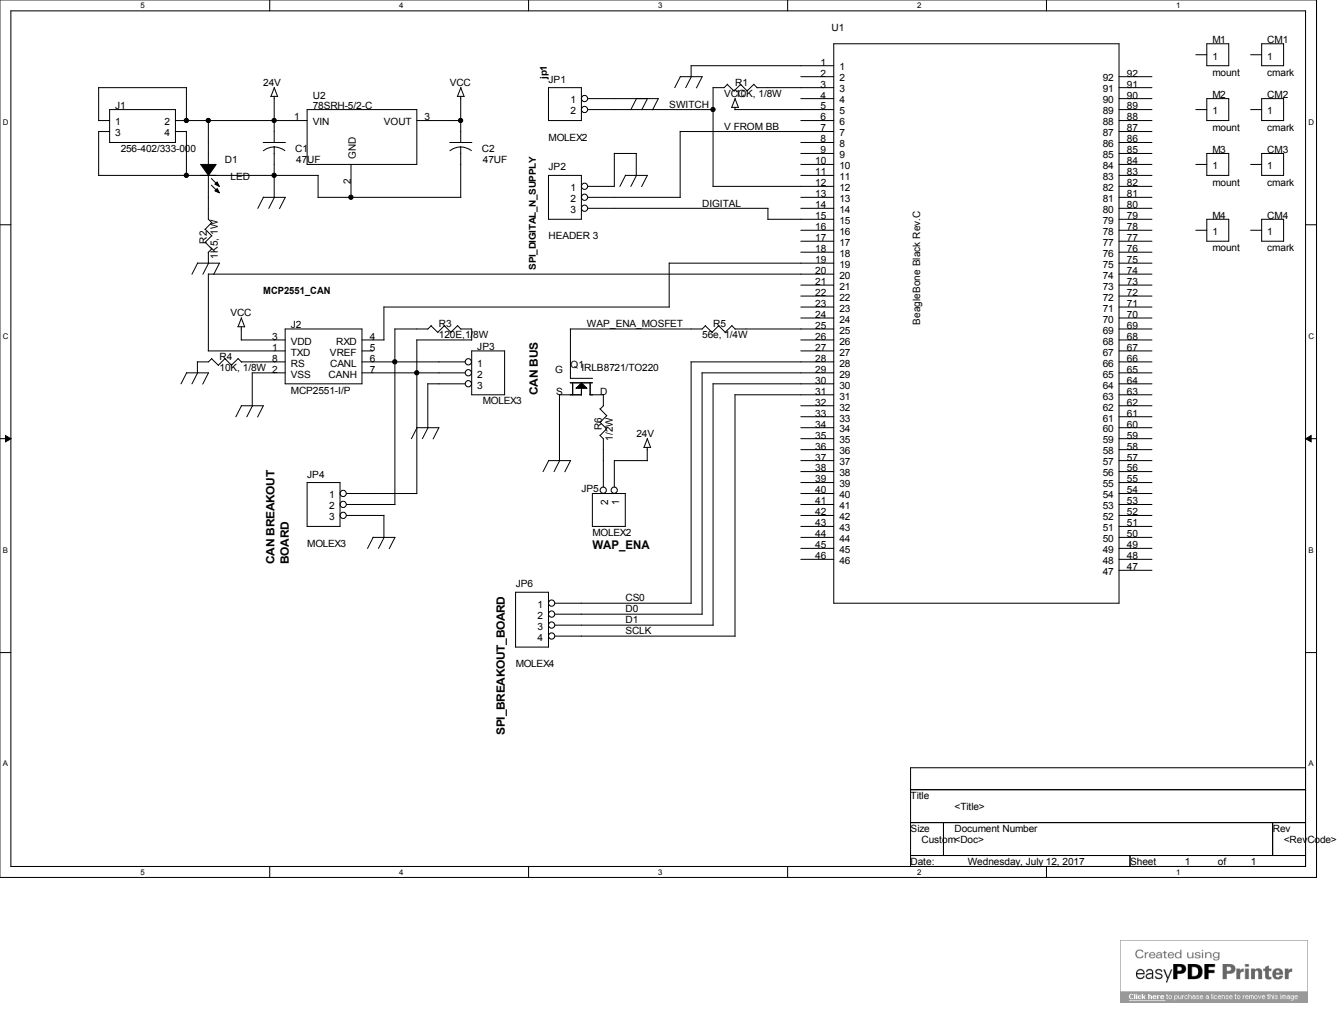
[picture p18: page 1]
