APathak666/Hyperloop-2017-Sorted-/PCB/PCBs_routed/FINAL_PCBS/comm pcb.pdf

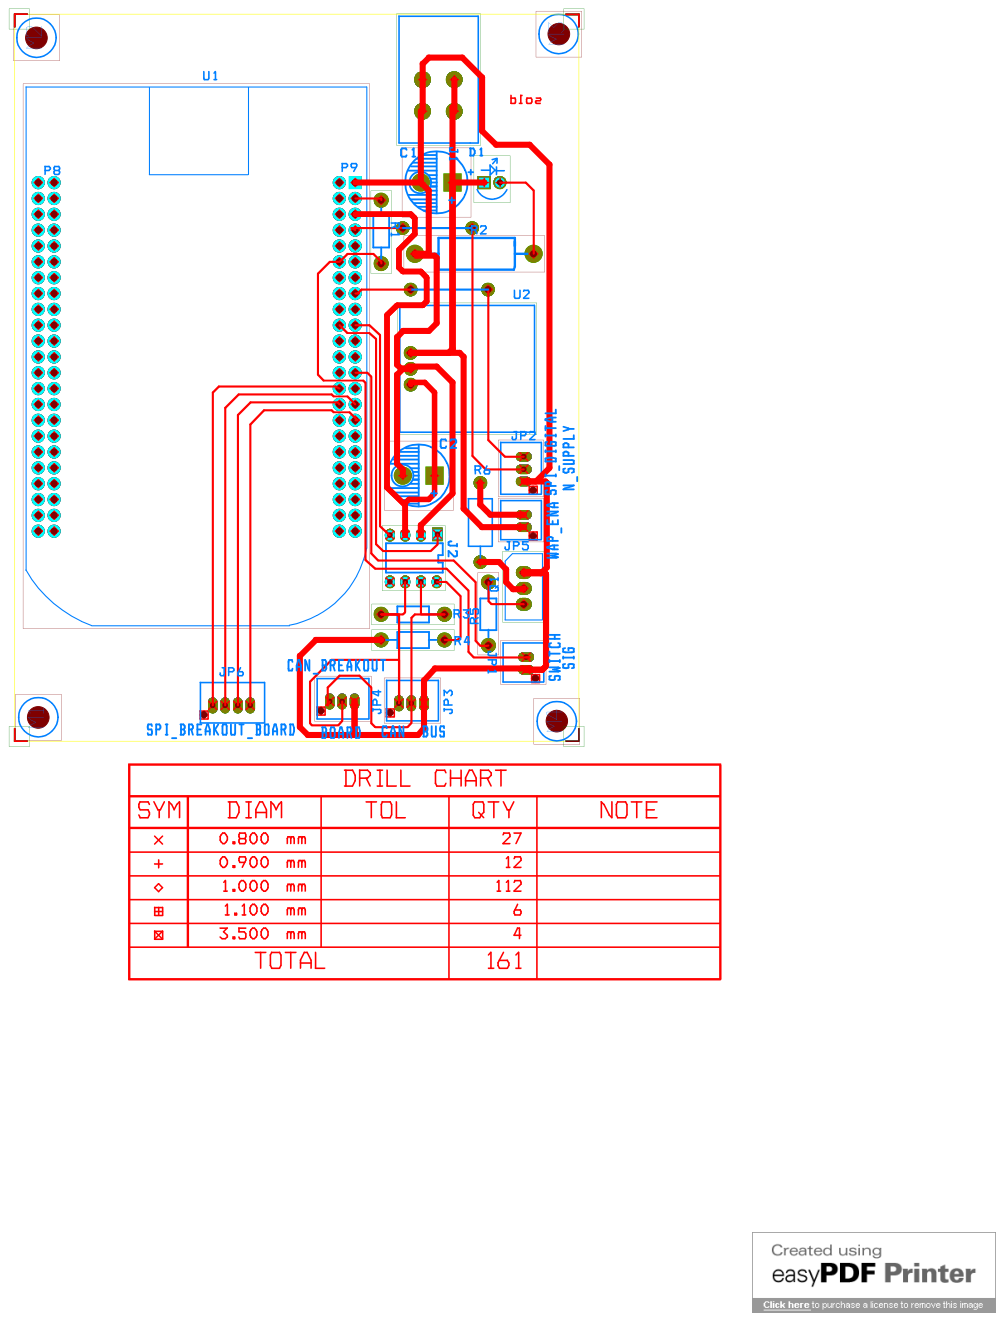
[picture p19: page 1]
