APathak666/Hyperloop-2017-Sorted-/Libraries_Drivers/MCP3008/examples/adcSimple/adcSimple.ino

/*
  Example for MCP3008 - Library for communicating with MCP3008 Analog to digital converter.
  Created by Uros Petrevski, Nodesign.net 2013
  Released into the public domain.
*/

#include <MCP3008.h>


// define pin connections
#define CS_PIN 12
#define CLOCK_PIN 9
#define MOSI_PIN 11
#define MISO_PIN 10

// put pins inside MCP3008 constructor
MCP3008 adc(CLOCK_PIN, MOSI_PIN, MISO_PIN, CS_PIN);

void setup() {
 
 // open serial port
 Serial.begin(9600);
  
}


void loop() {
  
  
  int val = adc.readADC(0); // read Chanel 0 from MCP3008 ADC
  Serial.println(val);
  
  
 
  for (int i=0; i<4; i++) {
   int val = adc.readADC(i);
   Serial.print(val);
   Serial.print("\t");
   }
   Serial.println("");
  
  
}
